dibakarbarua/TIADC_Firmware/README.md

TIADC-2012-13
=============

Road Accident Prevention Unit Multi Sensing-Actuation System for TIADC-2012/13. All India Third Prize Winner. C on the ARM Cortex M3 using TI's StellarisWare API
