dibakarbarua/TIADC_Firmware/Board Files/Board Files/Audio Amp/audioamp.png

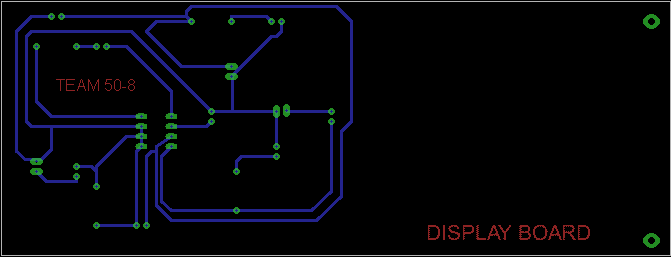
Board Files/Board Files/Audio Amp/audioamp.png
