dibakarbarua/TIADC_Firmware/Board Files/Board Files/SSD Board/SSD.png

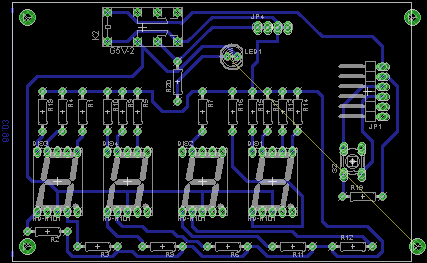
Board Files/Board Files/SSD Board/SSD.png
