dibakarbarua/TIADC_Firmware/Board Files/Board Files/SSD Board/testing.brd

## EAGLE design Board Files/Board Files/SSD Board/testing.brd (2014-02-06)

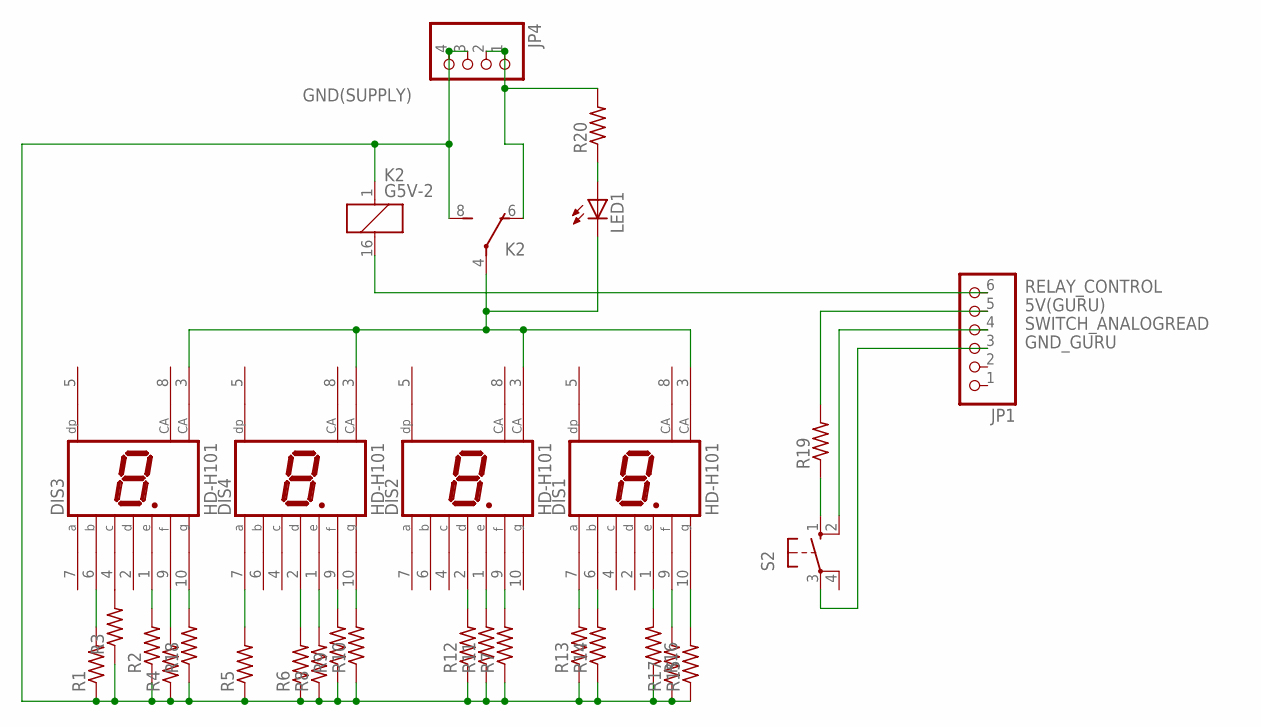
[picture p18: schematic testing.sch]

Parts:
DIS1, DIS2, DIS3, DIS4: HD-H101; HDSP-M
JP1: PINHD-1X6/90; 1X06/90
JP4: PINHD-1X4; 1X04
K2: G5V-2
LED1: LED5MM
R1, R2, R3, R4, R5, R6, R7, R8, R9, R10, R11, R12, R13, R14, R15, R16, R17, R18, R19, R20: RESISTOR0207/10; 0207/10
S2: 10-XX; B3F-10XX

Connections:
5V(GURU): JP1.5, R19.2
5V(SUPPLY): JP4.1, JP4.2, K2.6 (O), R20.2
GND(SUPPLY): JP4.3, JP4.4, K2.1, K2.8 (S), R1.1, R2.1, R3.1, R4.1, R5.1, R6.1, R7.1, R8.1, R9.1, R10.1, R11.1, R12.1, R13.1, R14.1, R15.1, R16.1, R17.1, R18.1
GND_GURU: JP1.3, S2.3
unnamed: DIS1.3 (CA), DIS2.3 (CA), DIS3.3 (CA), DIS4.3 (CA), K2.4, LED1.K (C)
unnamed: R19.1, S2.1 (S)
unnamed: LED1.A, R20.1
unnamed: DIS4.7 (A), R5.2
unnamed: DIS4.2 (D), R6.2
unnamed: DIS4.1 (E), R8.2
unnamed: DIS3.6 (B), R1.2
unnamed: DIS3.1 (E), R2.2
unnamed: DIS3.4 (C), R3.2
unnamed: DIS3.9 (F), R4.2
unnamed: DIS3.10 (G), R18.2
unnamed: DIS4.9 (F), R9.2
unnamed: DIS4.10 (G), R10.2
unnamed: DIS2.2 (D), R12.2
unnamed: DIS2.1 (E), R11.2
unnamed: DIS2.9 (F), R7.2
unnamed: DIS1.7 (A), R13.2
unnamed: DIS1.6 (B), R14.2
unnamed: DIS1.10 (G), R15.2
unnamed: DIS1.9 (F), R17.2
unnamed: DIS1.1 (E), R16.2
RELAY_CONTROL: JP1.6, K2.16 (2)
SWITCH_ANALOGREAD: JP1.4, S2.2 (S1)

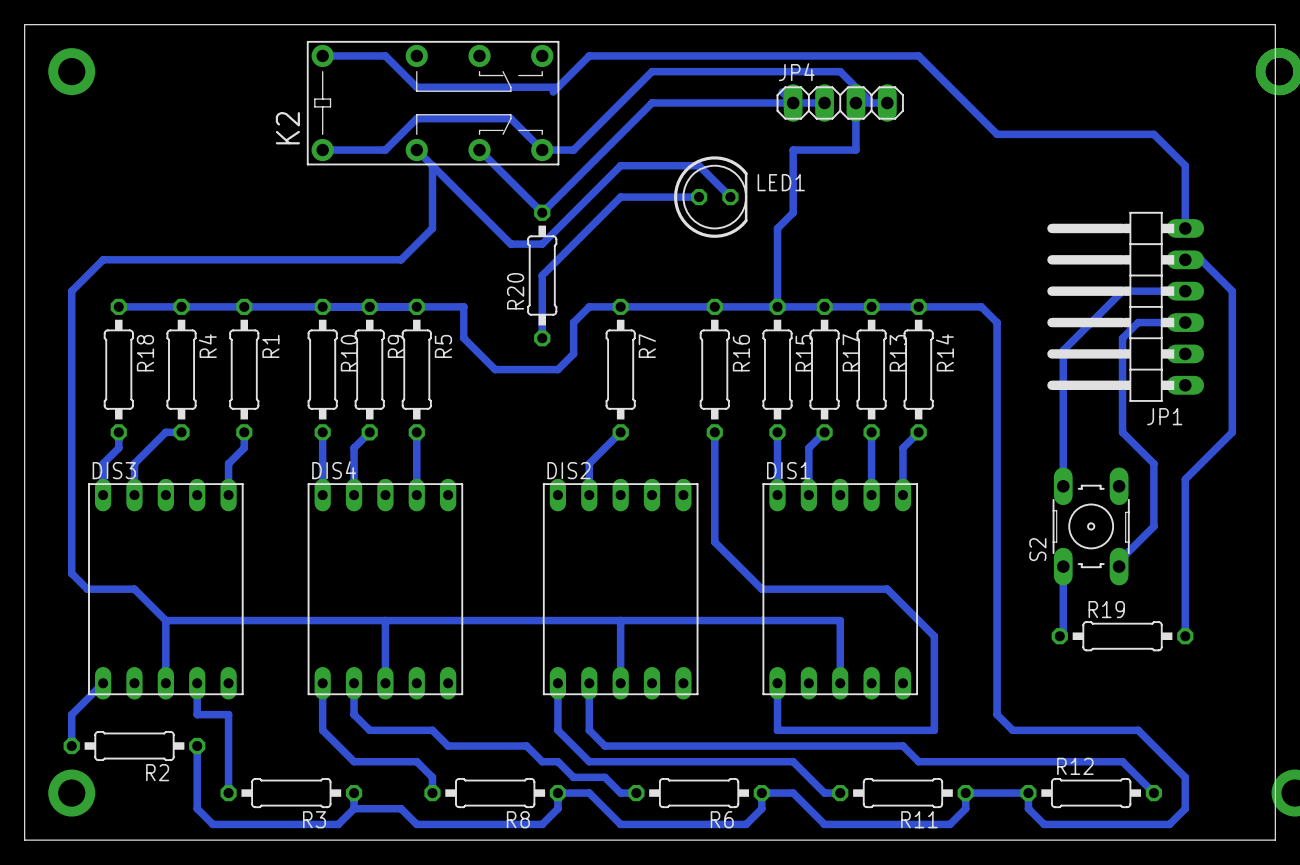
[picture p19: board testing.brd from above]

Board: 2 copper layers, 101.3 x 66.0 mm, 29 parts (0 on the bottom side), 27 nets.
