dibakarbarua/TIADC_Firmware/Board Files/Board Files/Audio Amp/audioamp.brd

## EAGLE design Board Files/Board Files/Audio Amp/audioamp.brd (2014-02-06)

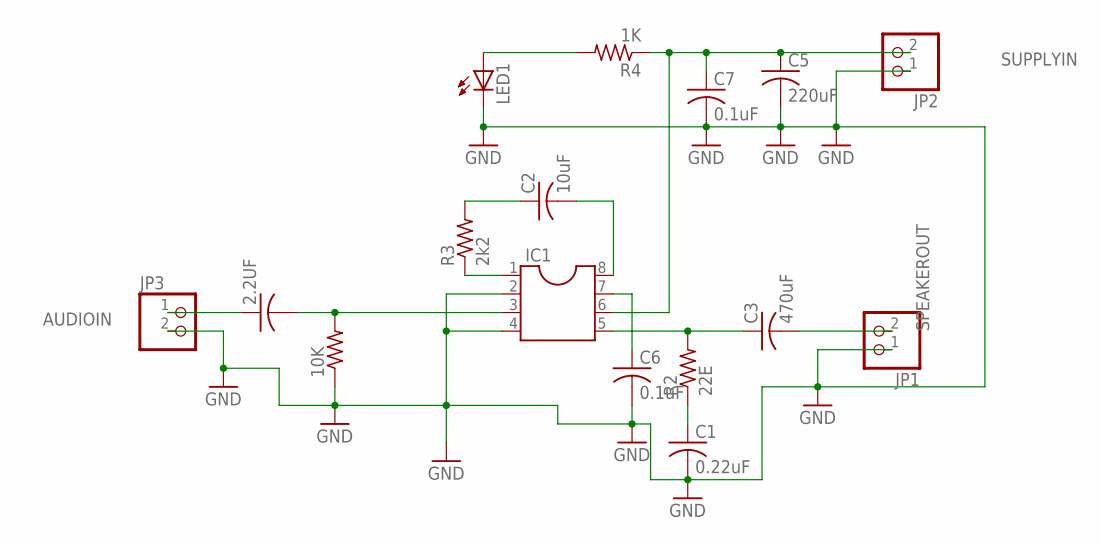
[picture p20: schematic audioamp.sch]

Parts:
2.2UF: C-US025-030X050; C025-030X050
10K: R-US_0207/10; 0207/10
C1: 0.22uF; C025-030X050
C2: 10uF; C025-030X050
C3: 470uF; C025-030X050
C5: 220uF; C025-030X050
C6, C7: 0.1uF; C025-030X050
IC1: DIL8; DIL08
JP1, JP2, JP3: PINHD-1X2; 1X02
LED1: LED5MM
R2: 22E; 0207/10
R3: 2k2; 0207/10
R4: 1K; 0207/10

Connections:
AUDIOIN: 2.2UF.1, JP3.1
GND: 10K.1, C1.2, C5.2, C6.2, C7.2, IC1.2, IC1.4, JP1.1, JP2.1, JP3.2, LED1.K (C)
unnamed: C2.1, R3.2
unnamed: IC1.1, R3.1
unnamed: C2.2, IC1.8
unnamed: C3.1, IC1.5, R2.2
unnamed: C1.1, R2.1
unnamed: C6.1, IC1.7
unnamed: 2.2UF.2, 10K.2, IC1.3
unnamed: LED1.A, R4.2
SPEAKEROUT: C3.2, JP1.2
SUPPLYIN: C5.1, C7.1, IC1.6, JP2.2, R4.1

Board: 2 copper layers, 16 parts (0 on the bottom side), 12 nets, no tracks yet.
