dibakarbarua/TIADC_Firmware/Board Files/Board Files/LCD Board/lcdboard.brd

## EAGLE design Board Files/Board Files/LCD Board/lcdboard.brd (2014-02-06)

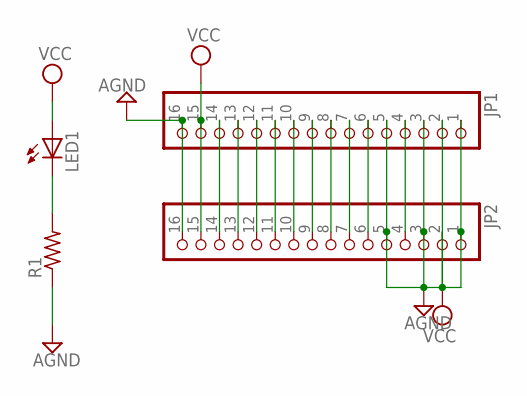
[picture p21: schematic lcdboard.sch]

Parts:
JP1, JP2: PINHD-1X16/90; 1X16/90
LED1: LED_ELD260; LED_LD260
R1: R-US_0204/7; 0204/7

Connections:
AGND: JP1.1, JP1.3, JP1.5, JP1.16, JP2.1, JP2.3, JP2.5, JP2.16, R1.1
unnamed: LED1.K (C), R1.2
unnamed: JP1.14, JP2.14
unnamed: JP1.13, JP2.13
unnamed: JP1.12, JP2.12
unnamed: JP1.11, JP2.11
unnamed: JP1.10, JP2.10
unnamed: JP1.9, JP2.9
unnamed: JP1.8, JP2.8
unnamed: JP1.7, JP2.7
unnamed: JP1.6, JP2.6
unnamed: JP1.4, JP2.4
VCC: JP1.2, JP1.15, JP2.2, JP2.15, LED1.A

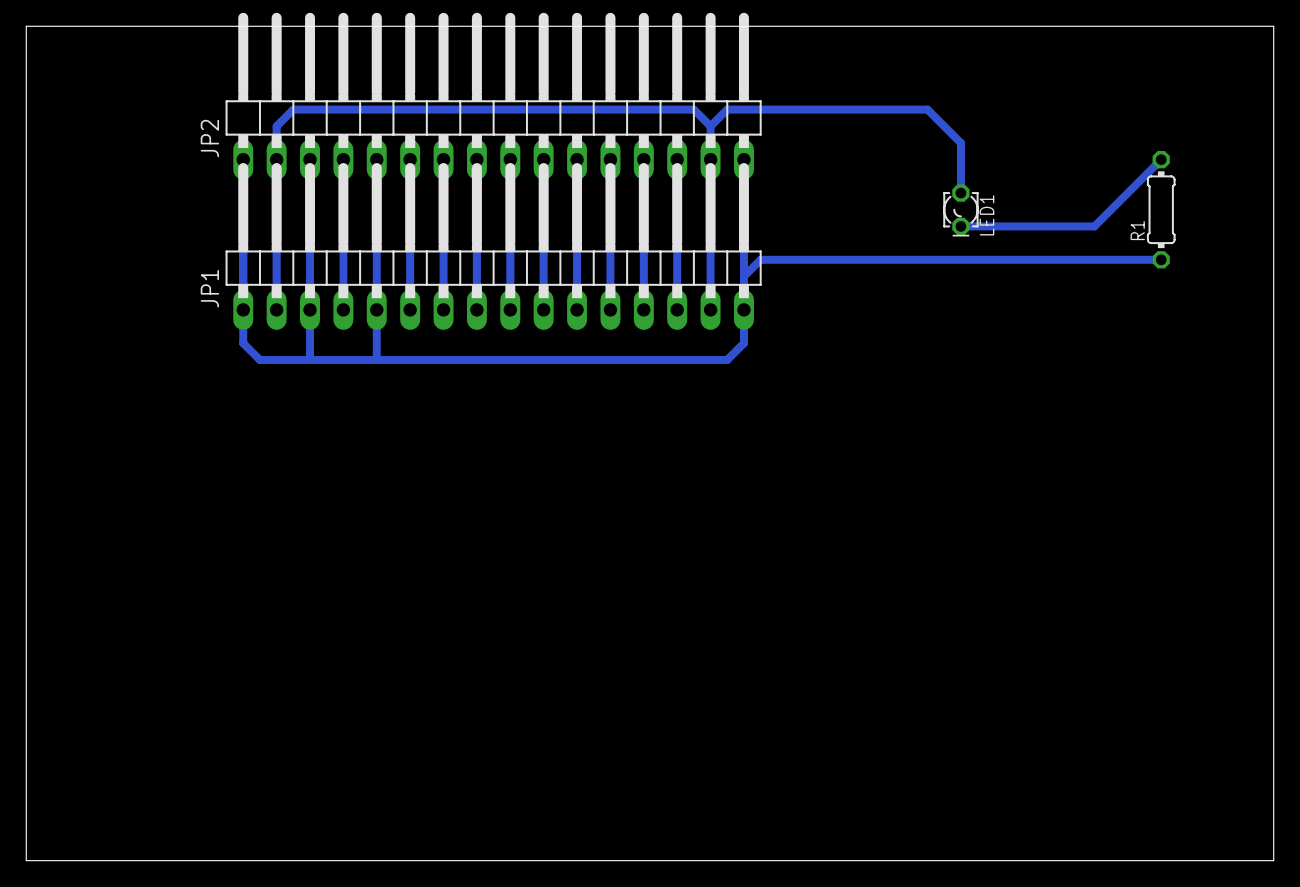
[picture p22: board lcdboard.brd from above]

Board: 2 copper layers, 94.9 x 63.5 mm, 4 parts (0 on the bottom side), 13 nets.
